WOODWERD/cyd-case/THIRD_PARTY_NOTICES.md

# Third-party notices

The WOODWERD CYD Case (STL, STEP, drawings, guides) is © 2026 WOODWERD LLC and MIT-licensed (see `LICENSE`). It was designed in Autodesk Fusion by WOODWERD LLC.

## References used in the design

- The case was designed around the CYD board CAD model published in [witnessmenow/ESP32-Cheap-Yellow-Display](https://github.com/witnessmenow/ESP32-Cheap-Yellow-Display) (`3dModels/Havenview_CYD_CAD`), which is MIT-licensed. That model is **not** redistributed here; only the case bodies designed around it are.
- The USB-C opening and funnel dimensions follow the public *USB Type-C Cable and Connector Specification*, Appendix B.
- "Cheap Yellow Display" / CYD is a community nickname for the Sunton ESP32-2432S028 board. No Sunton documentation is redistributed.

## Trademarks

Product names in the compatibility table (Flow Ctrl, Media Ctrl) are WOODWERD projects. Third-party names mentioned in those projects' own docs belong to their owners.
