WOODWERD/cyd-case/housings/v3/CYD_Case_v3_Lid.step

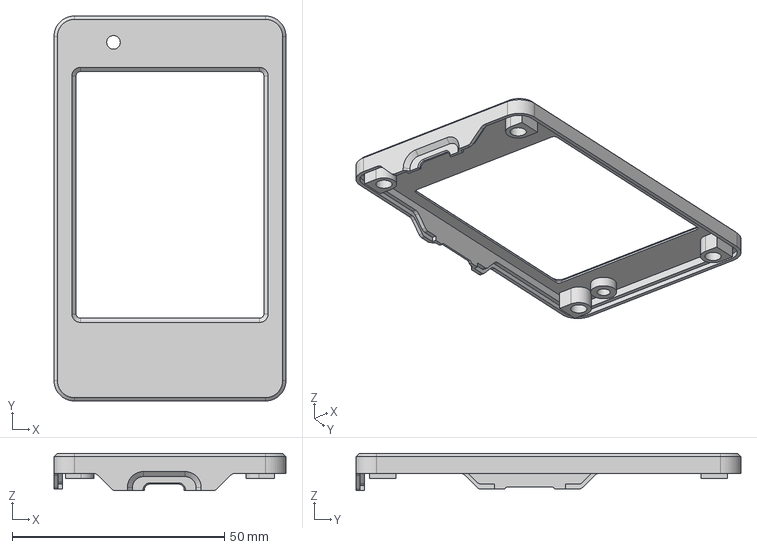
[picture p8: CAD file, 2026-10-29]
housings/v3/CYD_Case_v3_Lid.step
54.6 x 90.6 x 8.80 mm
