WOODWERD/cyd-case/housings/v3/CYD_Case_v3_LightPipe.step

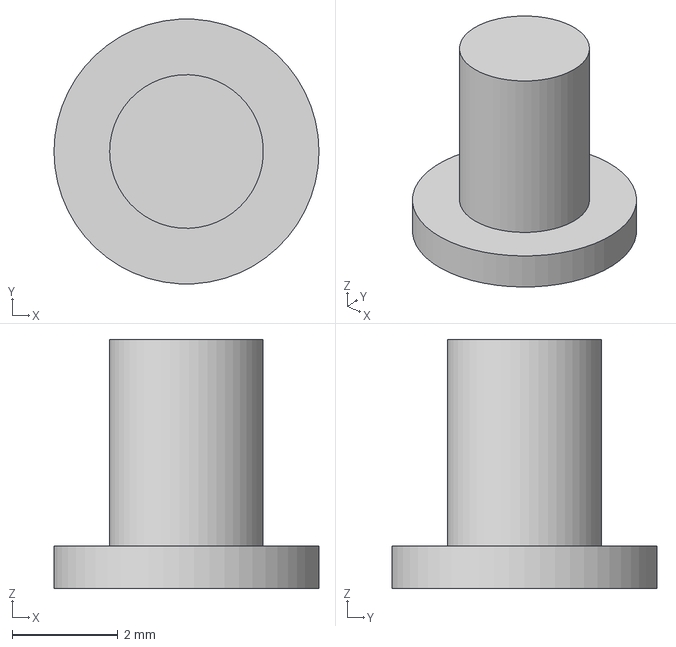
[picture p9: CAD file, 2026-10-29]
housings/v3/CYD_Case_v3_LightPipe.step
5.00 x 4.99 x 4.70 mm
