WOODWERD/cyd-case/housings/v3/CYD_Case_v3_Base.step

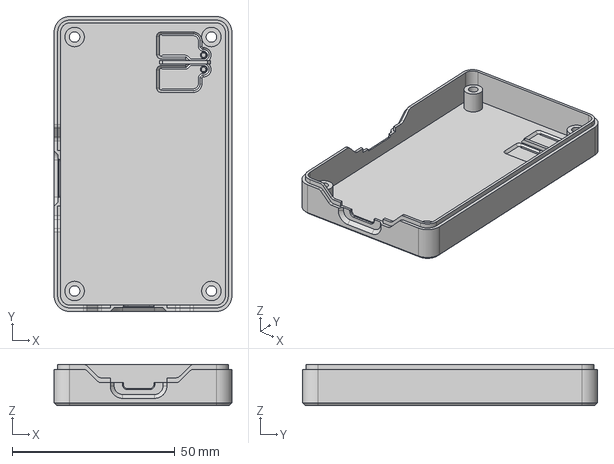
[picture p10: CAD file, 2026-10-29]
housings/v3/CYD_Case_v3_Base.step
54.6 x 90.6 x 12.6 mm
