WOODWERD/cyd-case/housings/v2/CYD_Case_v2_Base.step

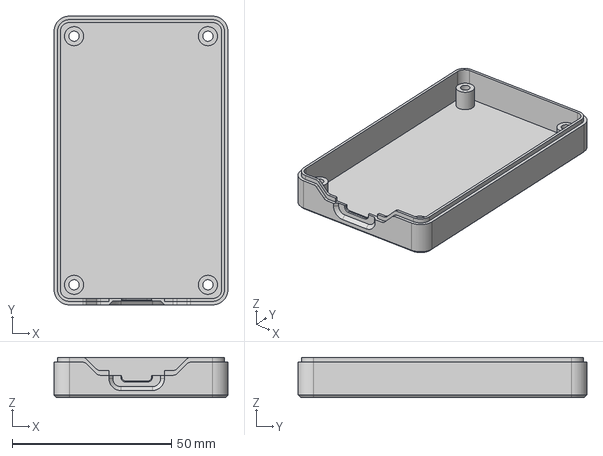
[picture p11: CAD file, 2026-10-23, an earlier design]
housings/v2/CYD_Case_v2_Base.step
54.6 x 90.6 x 12.6 mm
