WOODWERD/cyd-case/housings/v2/CYD_Case_v2_Lid.step

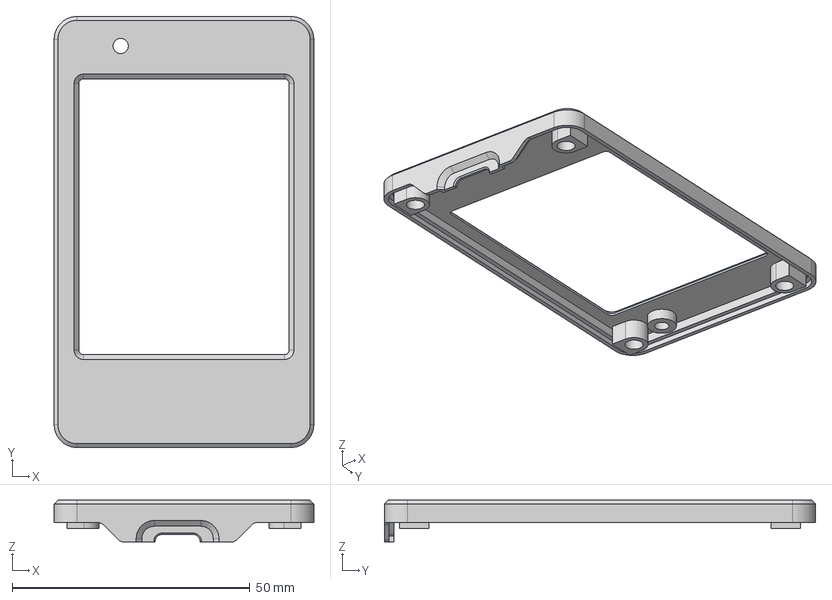
[picture p12: CAD file, 2026-10-23, an earlier design]
housings/v2/CYD_Case_v2_Lid.step
54.6 x 90.6 x 8.80 mm
