WOODWERD/cyd-case/(list of files, cad)

Other CAD files:
housings/v2/CYD_Case_v2_LightPipe.step
housings/v2/CYD_Case_v2_Base.stl
housings/v2/CYD_Case_v2_Lid.stl
housings/v2/CYD_Case_v2_LightPipe.stl
housings/v3/CYD_Case_v3_Base.stl
housings/v3/CYD_Case_v3_Lid.stl
housings/v3/CYD_Case_v3_LightPipe.stl
