WOODWERD/cyd-case/(commit log)

2026-10-23 WOODWERD CYD Case — housing v2, BOM, build guide (moved from Flow Ctrl)
    Claude-Session: https://claude.ai/code/session_01UKpJi9XFUhPJjswd5k6SHJ
    [BOM.csv, CYD_Case_v2_Base.step, CYD_Case_v2_Base.stl, CYD_Case_v2_Lid.step, CYD_Case_v2_Lid.stl, CYD_Case_v2_LightPipe.step, CYD_Case_v2_LightPipe.stl]
2026-10-29 update to V3
    [BOM.csv, CYD_Case_v3_Base.step, CYD_Case_v3_Base.stl, CYD_Case_v3_Lid.step, CYD_Case_v3_Lid.stl, CYD_Case_v3_LightPipe.step, CYD_Case_v3_LightPipe.stl]
2026-11-01 Update CtrlClock and Ctrl Case in All tools
    CtrlClock is built and in verification. Ctrl Case has housings for the 2.8" board only.
